slopma/Cocoa-Capacitive-Detection/README.md

# Cocoa Capacitive Detection

##  Project Overview
Cocoa-Capacitive-Detection is a non-invasive sensor system designed to measure the capacitance of cocoa fruits to determine their ripening stages and detect fungal infections caused by *Moniliophthora roreri*. The system employs a Sauty bridge circuit to obtain real-time capacitance measurements without causing damage to the fruit.

##  Motivation
Capacitance is recognized as an effective physiological indicator due to its correlation with moisture content, cell development, and glucose levels. Based on this premise, our hypothesis is that capacitance measurements are directly related to fruit ripening and fungal infection.

## Key Features
-  **Non-invasive detection** of cocoa ripening stages and fungal infections.
-  **Energy-efficient system**, optimized for field applications.
-  **Sauty Bridge-based circuit** operating at 10V peak and 1 kHz.
-  **Experimentally validated** under controlled conditions with CNCH13 cocoa variety.

##  Repository Structure
```
 Cocoa-Capacitive-Detection
 ├──  docs              # Documentation and references
 ├──  hardware          # Circuit schematics and hardware design
 ├──  firmware          # Source code for capacitance measurement
 ├──  data              # Experimental results and analysis
 ├── README.md          # This file 
```
---

For further details, please refer to the **docs/** directory or contact the project **contributors**.

*   [David Velásquez](https://github.com/dvelaren)
*   [Joan Alvarado](https://github.com/joanfco30)
*   [Ossman López](https://github.com/Ossduque)
*   [Juan Pablo Díaz](https://github.com/jpdgz2002)
*   [Sara López Marín](https://github.com/slopma)
