slopma/Cocoa-Capacitive-Detection/data/Mediciones_Circuito - Condensadores.pdf

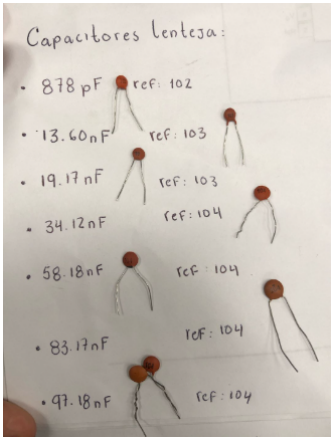
[picture p9: figure]

Condensadores tipo Lenteja utilizados

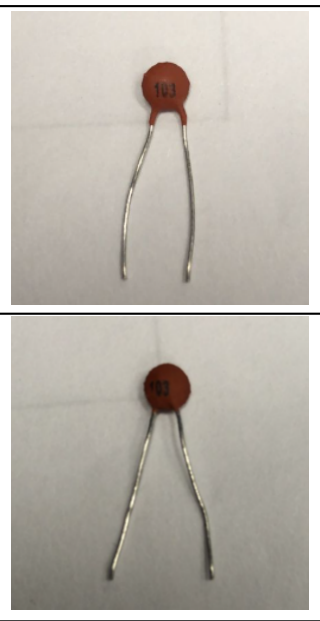
[picture p10: figure]

Evidencia | Valor | Ref | Evidencia | Valor | Ref | General | Capacitor del filtro

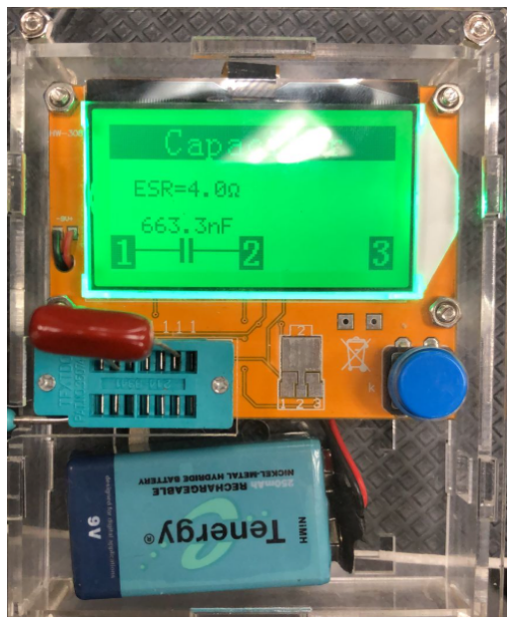
[picture p11: figure]

| 878 pF | #102 | | 58.18 nF | #104
| 13.60 nF | #103 | | 83.17 nF | #104
| 19.17 nF | #103 | | 97.18 nF | #104
| 34.12 nF | #104
