slopma/Cocoa-Capacitive-Detection/hardware/circuito_final.PDF

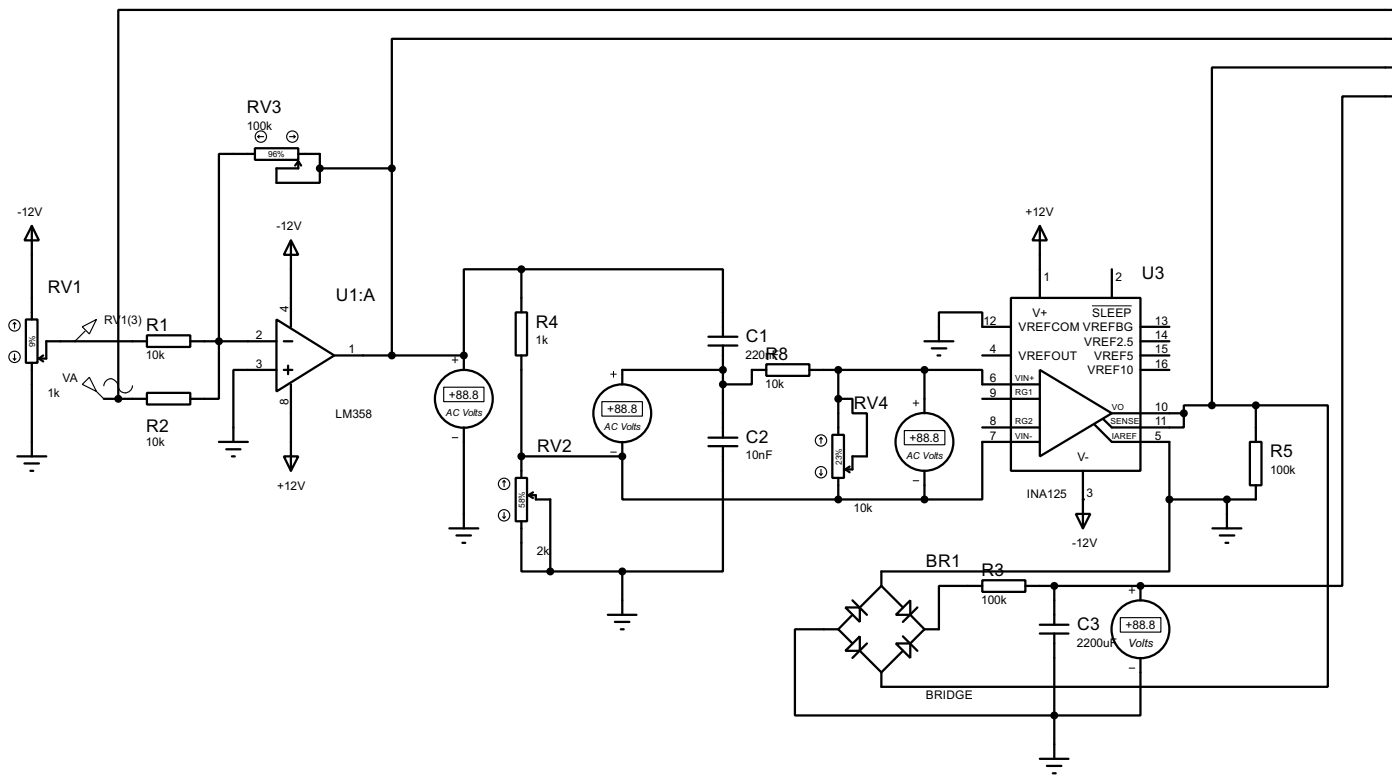
[picture p12: page 1]
