slopma/Cocoa-Capacitive-Detection/(list of files, drawings)

Other design files:
hardware/circuito_final.pdsprj
