slopma/Cocoa-Capacitive-Detection/(commit log)

2025-03-26 Circuit schematics and hardware design
2025-03-26 Source code for capacitance measurement
2025-03-26 Added circuit.pdf to hardware
